andtc/Robot_Arm/Images/23HS22-2804D-E1000.jpg

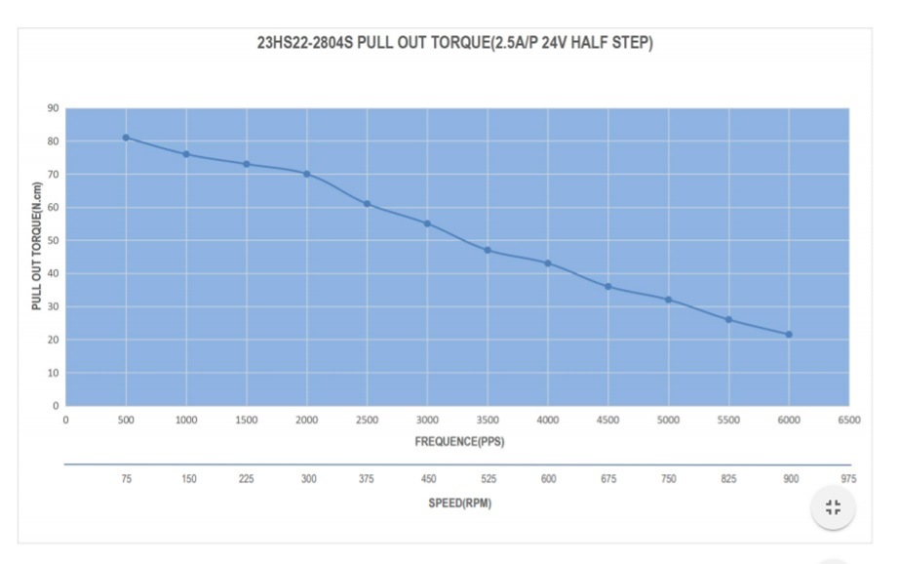
Images/23HS22-2804D-E1000.jpg
