andtc/Robot_Arm/Images/34HS31-5504D-E1000.jpg

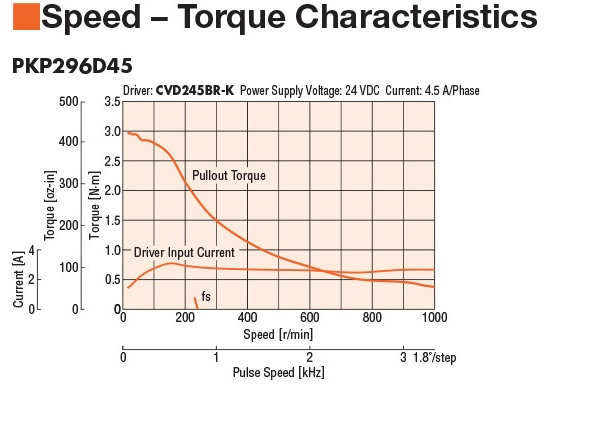
Images/34HS31-5504D-E1000.jpg
