andtc/Robot_Arm/DXF/AS3.dxf

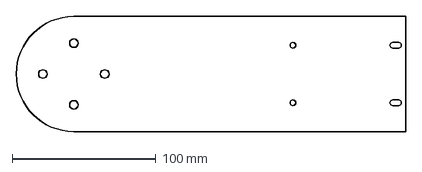
[picture p29: CAD file, 2018-04-20]
DXF/AS3.dxf
270.8 x 80.0 mm
