andtc/Robot_Arm/DXF/AS2.dxf

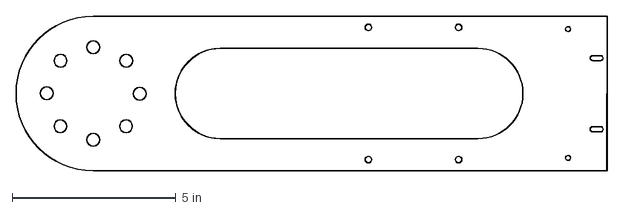
[picture p30: CAD file, 2018-04-20]
DXF/AS2.dxf
18.1 x 4.72 in
