andtc/Robot_Arm/Specifications Sheets/23HS22-2804D-E1000.pdf

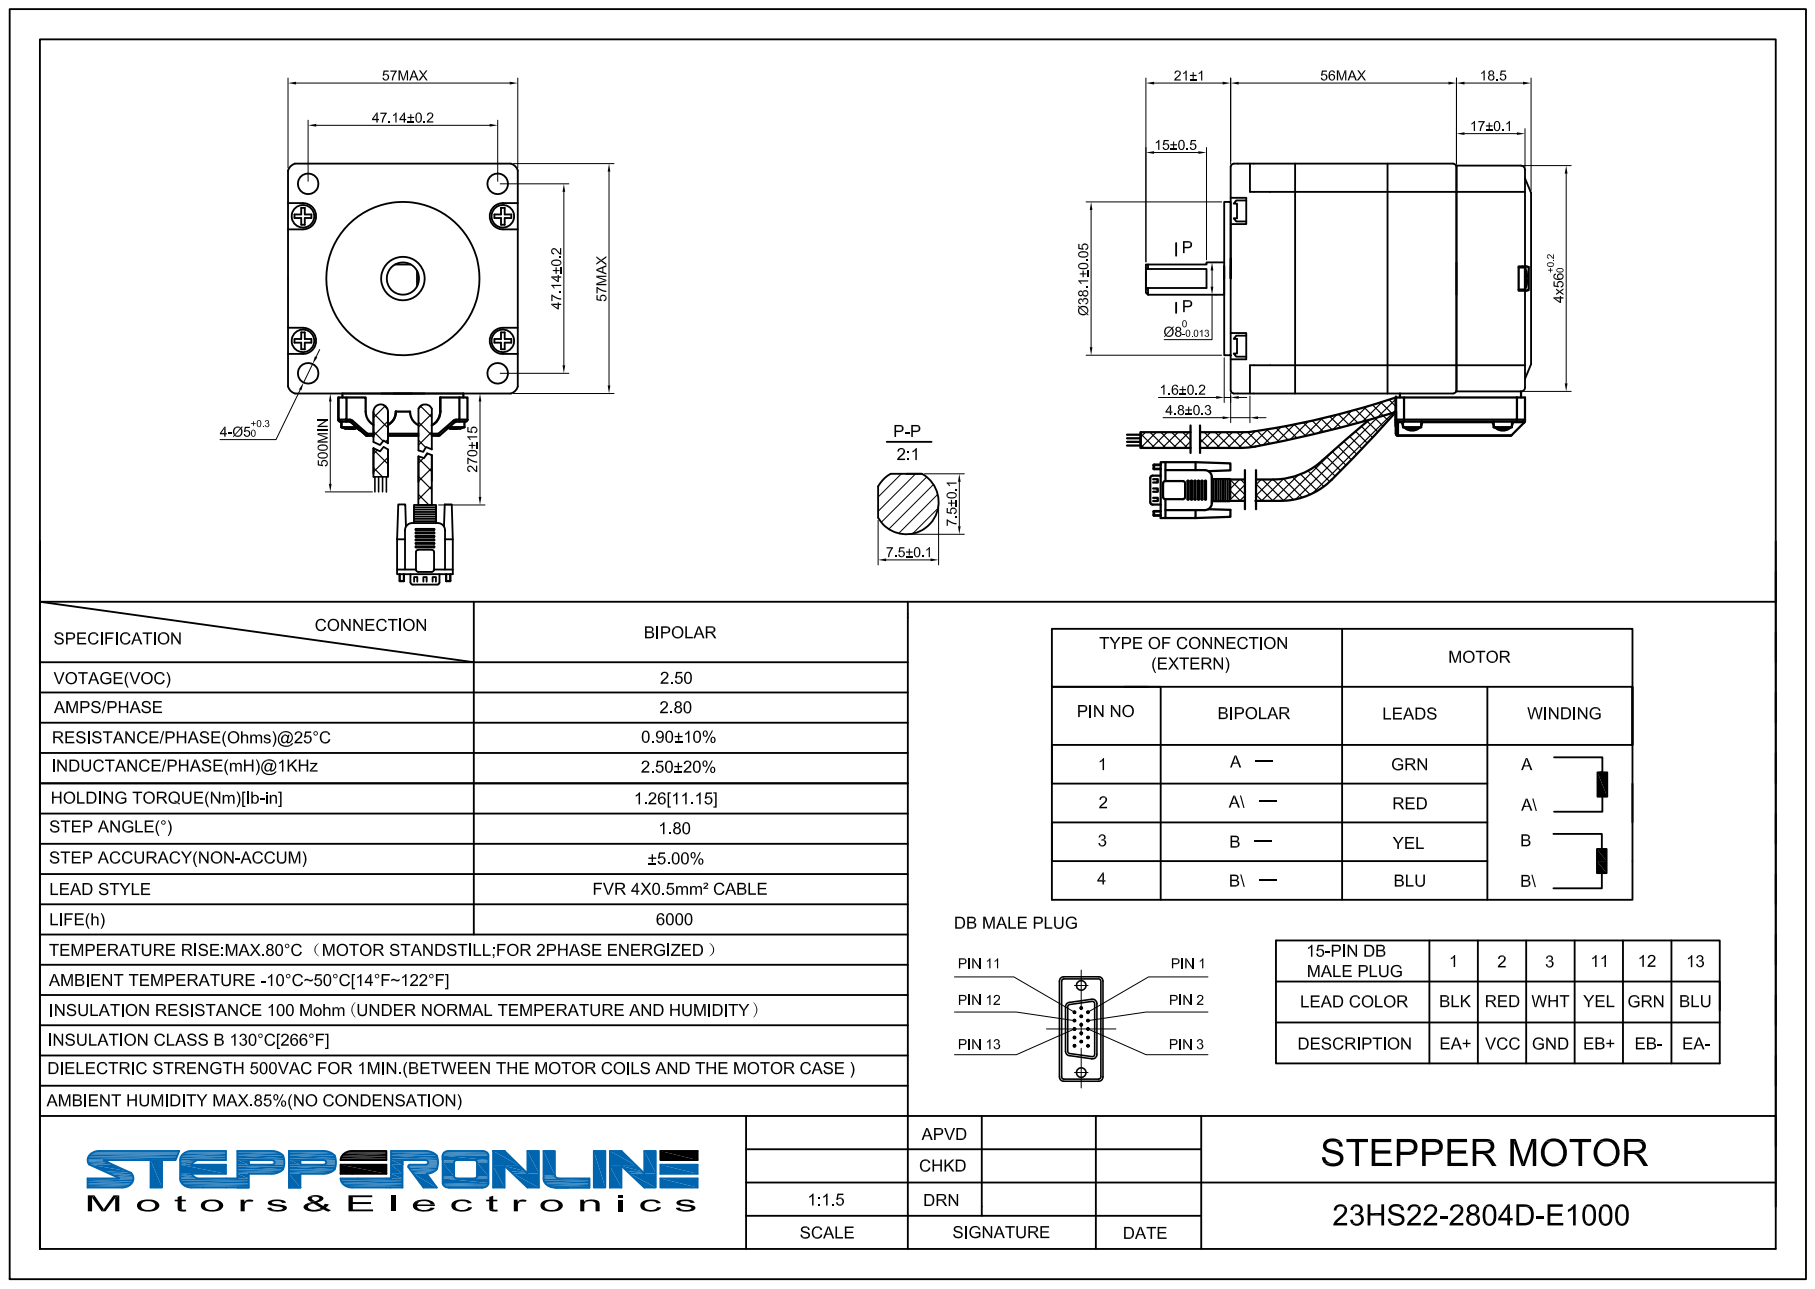
[picture p31: page 1]
