andtc/Robot_Arm/Specifications Sheets/23HS22-2804S.pdf

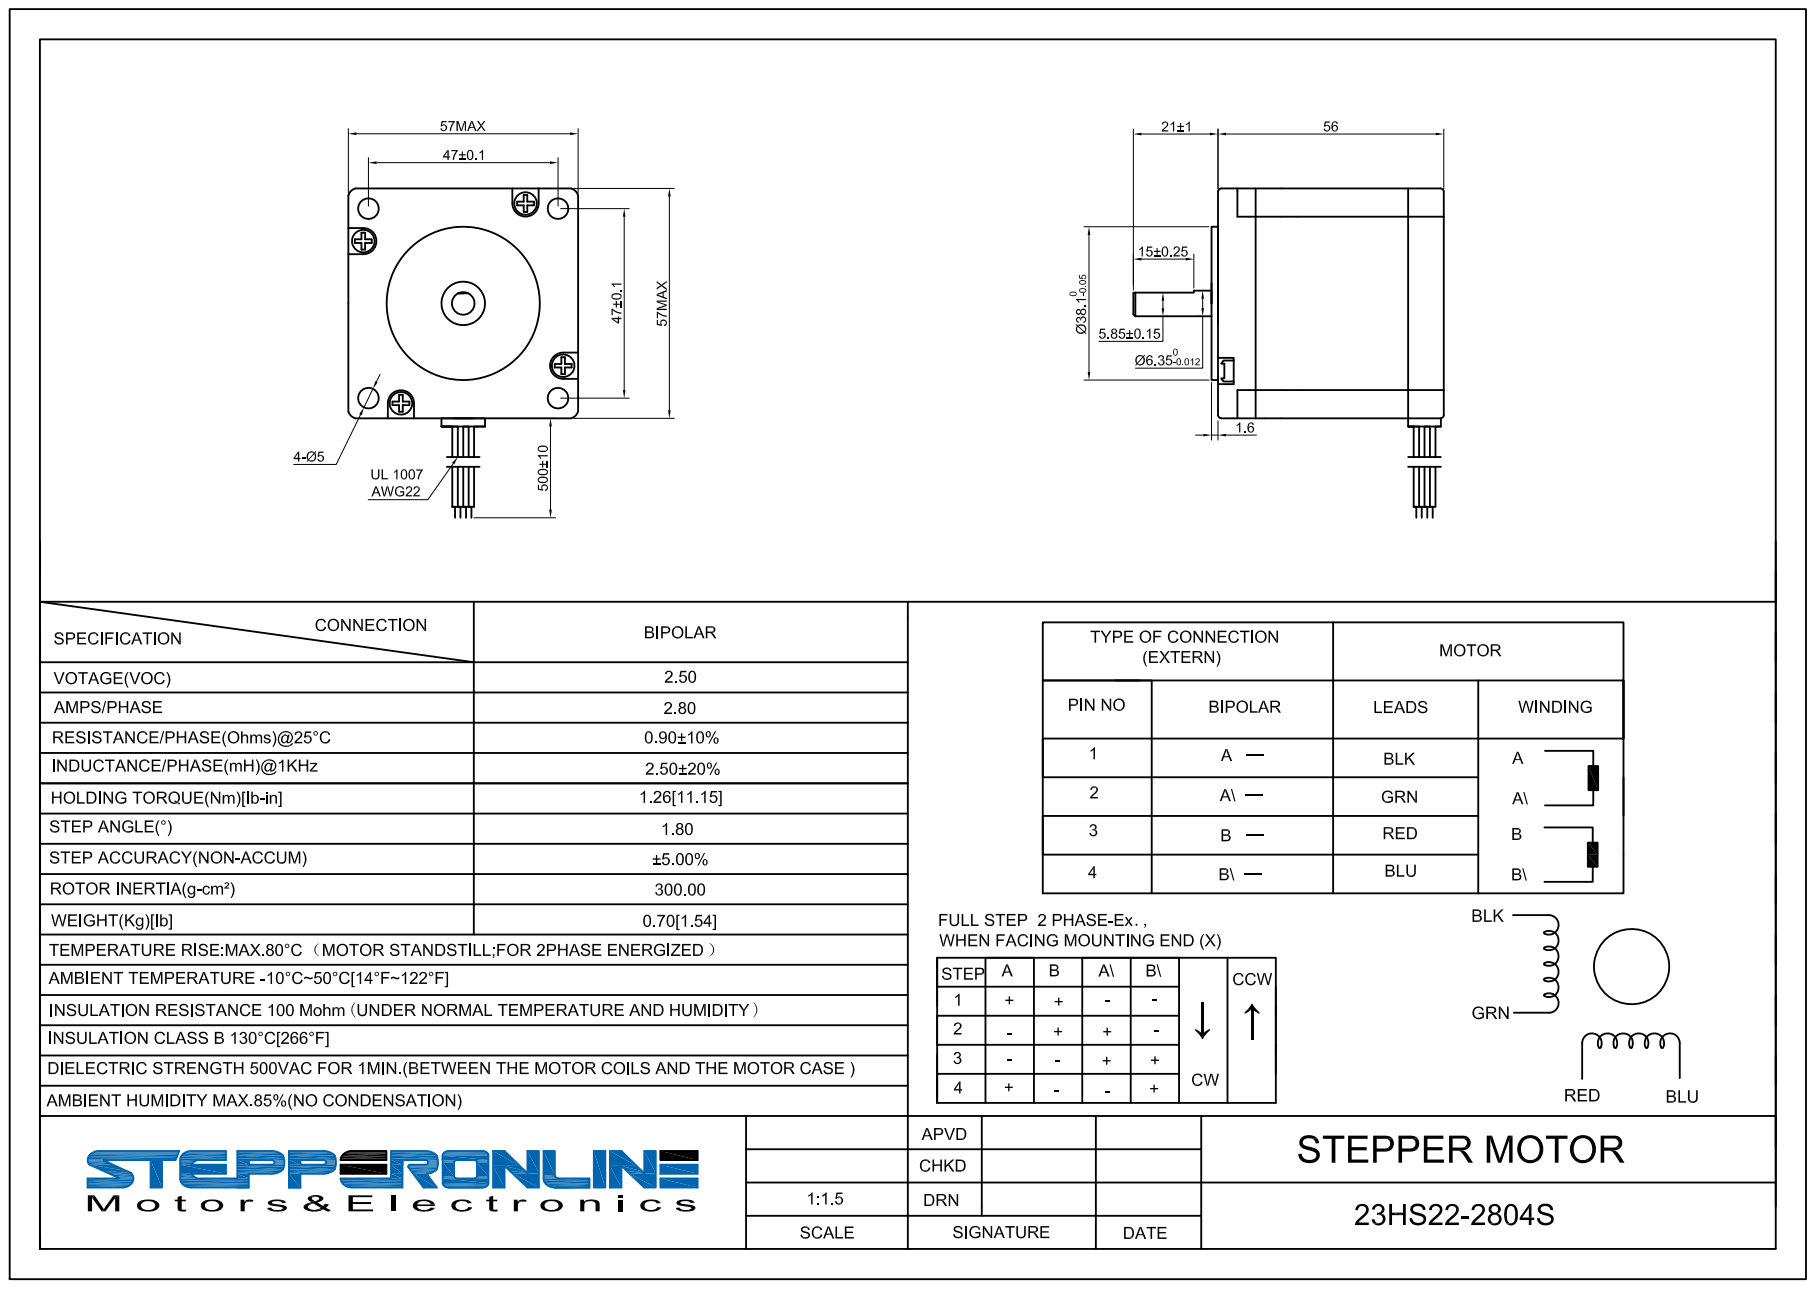
[picture p32: page 1]
