andtc/Robot_Arm/Specifications Sheets/34HS31-5504D-E1000.pdf

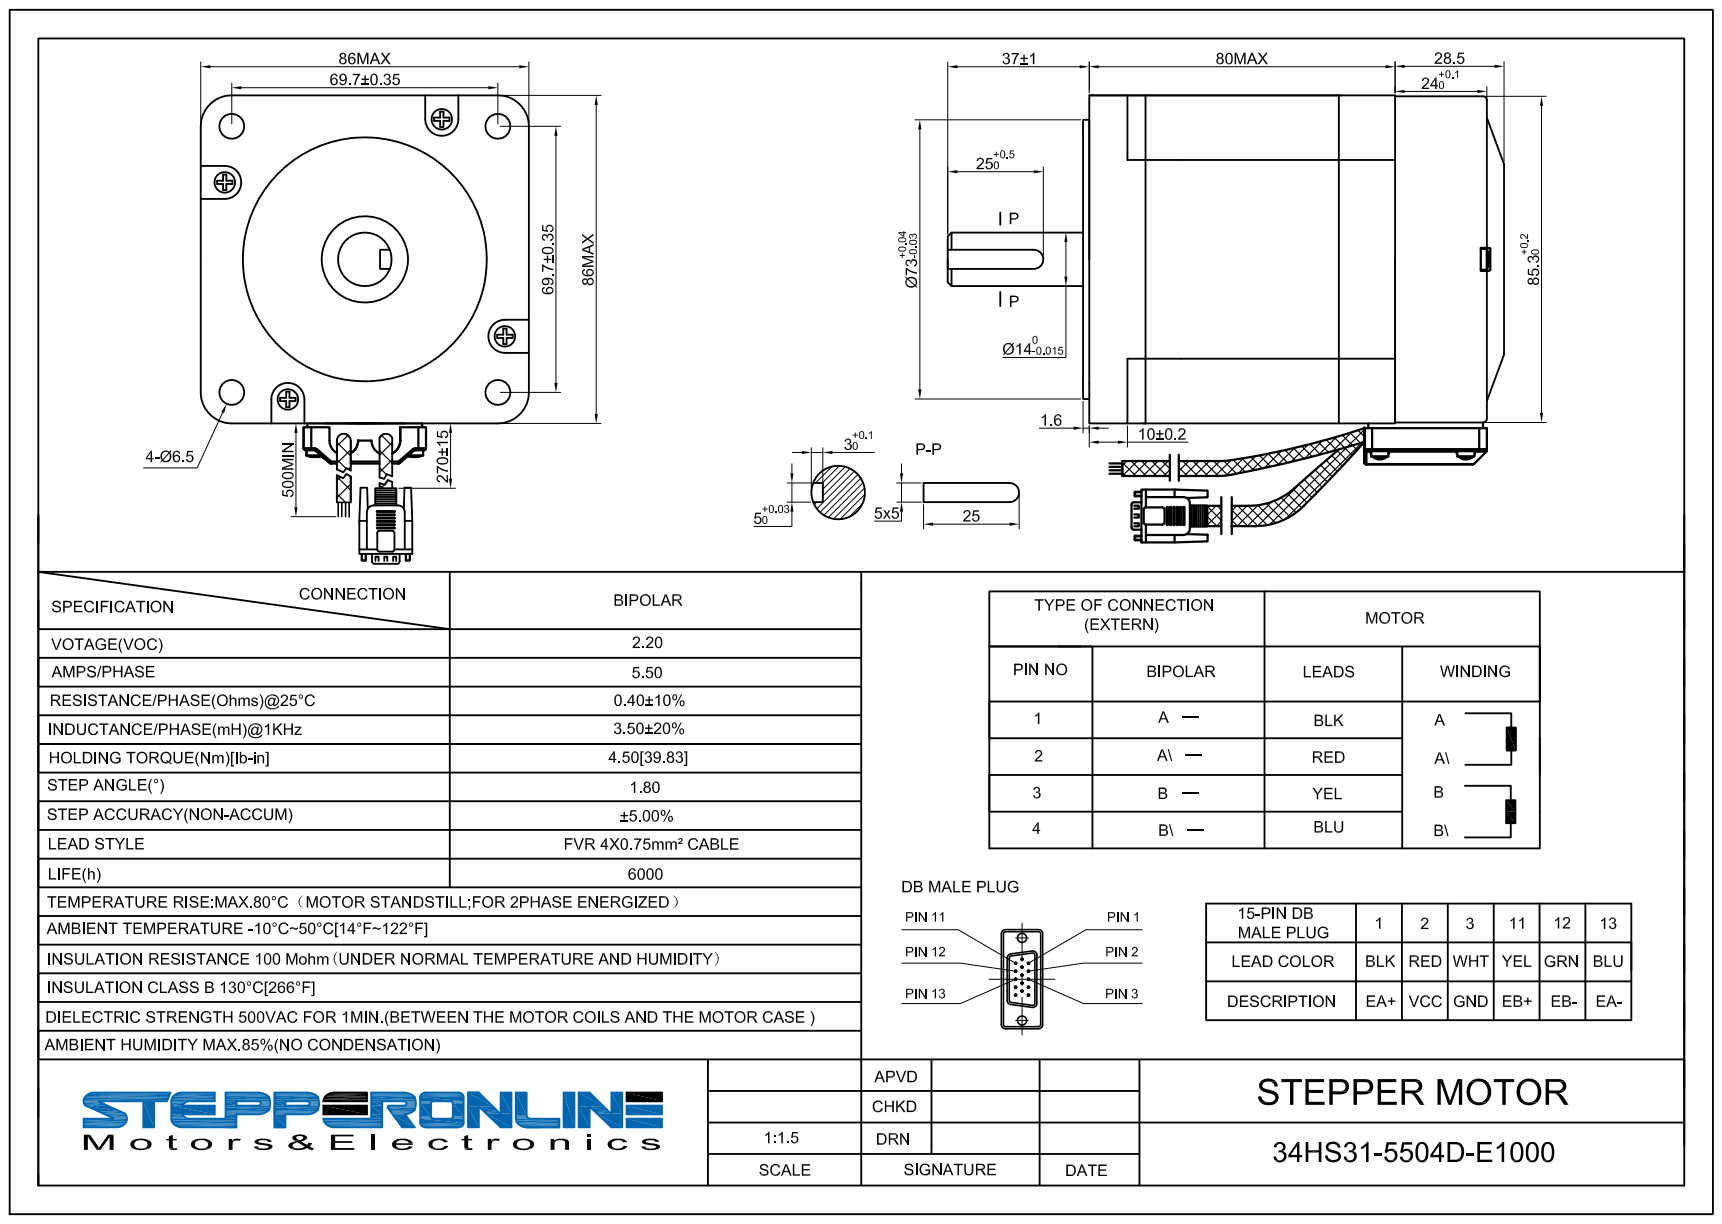
[picture p33: page 1]
