andtc/Robot_Arm/Specifications Sheets/34HS31-5504D.pdf

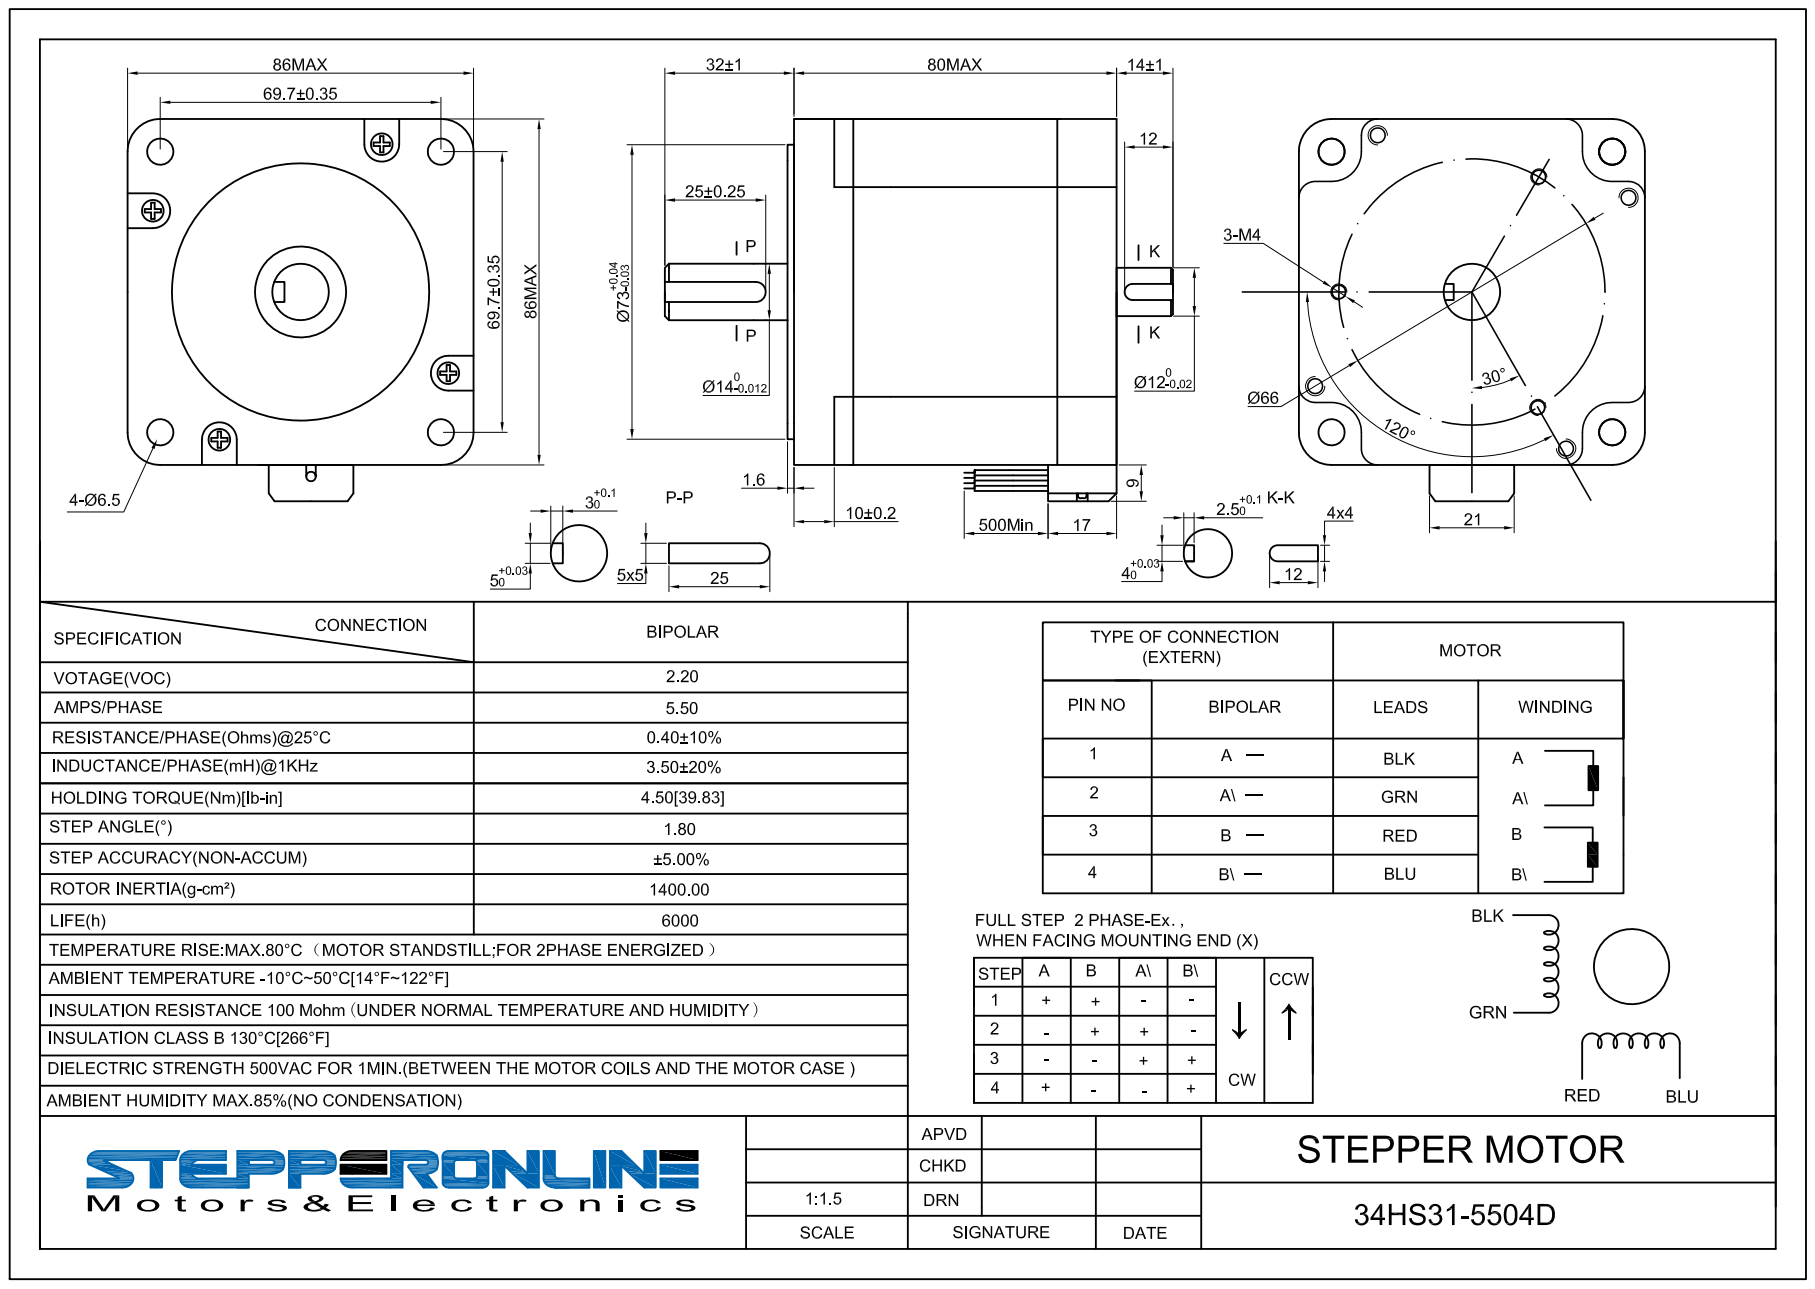
[picture p34: page 1]
