andtc/Robot_Arm/DXF/AS2.pdf

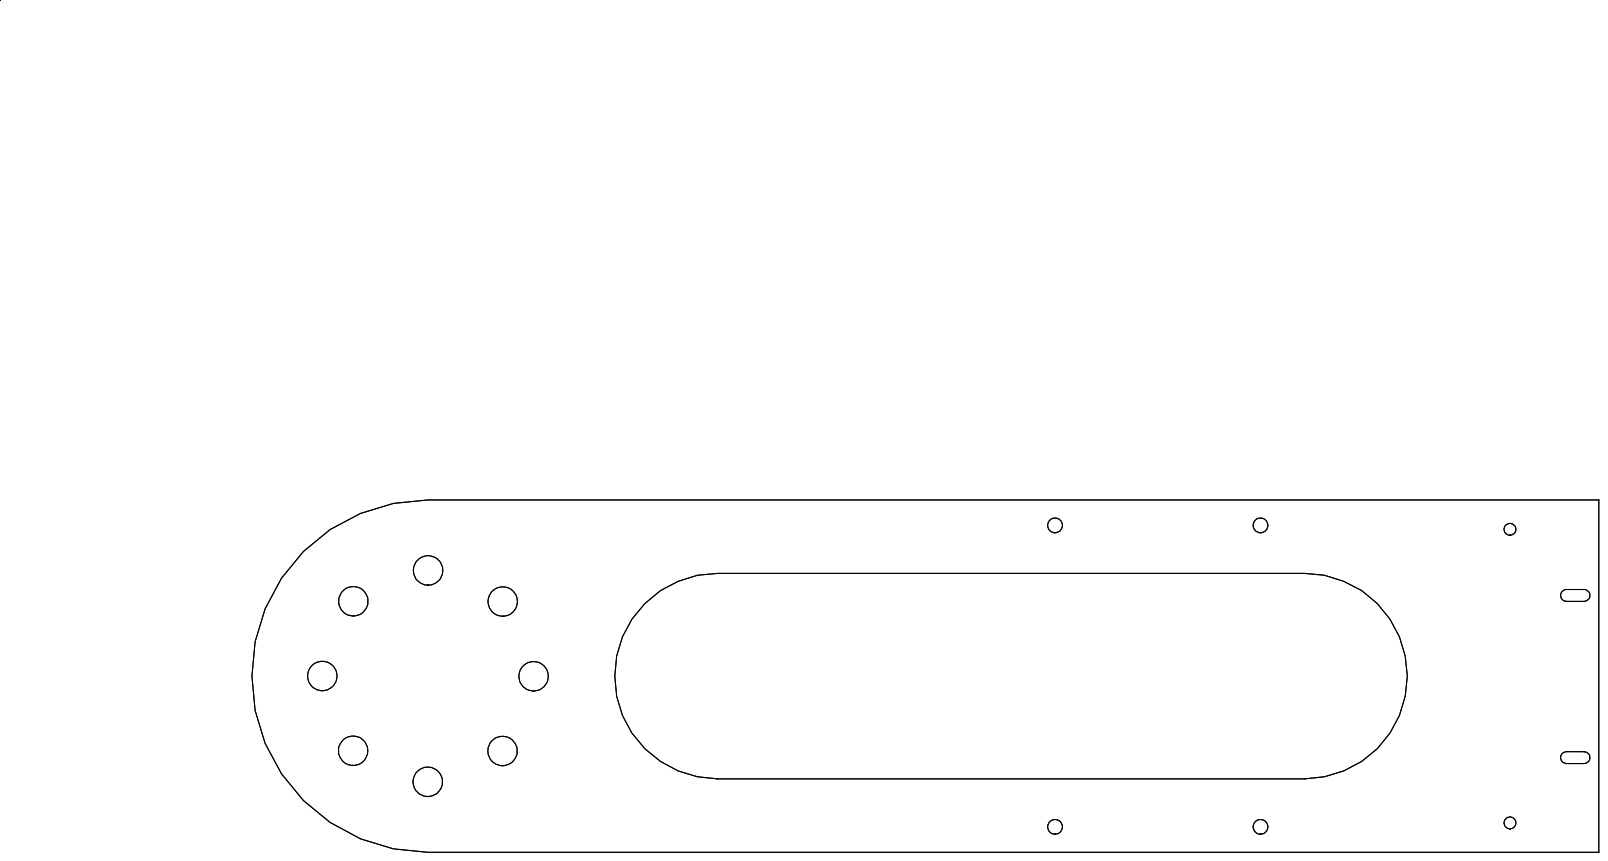
[picture p35: page 1]
