andtc/Robot_Arm/(commit log)

2018-03-12 updated code
    [IGUS Joint Calculations.xlsx]
2018-03-13 code 3_13_2018
    [DOF Motor Calculations.xlsx, DOF_Movement.xlsx, IGUS Joint Calculations.xlsx]
2018-04-20 added fusion files
    [AS2.dxf, AS3.dxf, transforms.csv]
